marceloxreis/sistema-embarcados/(commit log)

2026-10-22 Entrega inicial: controle de acesso ESP32 com biometria, auditoria e buzzer
    [BuzzerLogic.h, Config.example.h, DoorLogic.h, test_buzzer.cpp, test_buzzer.py, test_door.cpp, test_server.py]
2026-10-30 Arquitetura Mega 2560 + ESP32-CAM com foto por acesso autorizado
    - Firmware MegaControlador: controle local, EEPROM com journal, contador de
    boot, fila de eventos, UART com a CAM atendida durante esperas, recuperacao
    de DY50/LCD, diagnostico BOOT/STATUS.
    - Firmware Esp32CamRede: captura com prova de frescor, fila com JPEG, envio
    HTTP com descarte de rejeicao permanente e espera entre reenvios, NTP,
    encaminhamento de reset web.
    - Protocolo UART compartilhado (enquadramento, CRC, mensagens).
    - Servidor: fotos, contadores de perda, expiracao de reset pendente,
    respostas 400/404 robustas; painel com tratamento de sessao e erros.
    - Testes de host com dubles (126), guia de montagem fio a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
    [BootCounter.h, BuzzerLogic.h, Config.example.h, DoorLogic.h, Dy50ResponseFilter.h, Esp32CamRede.ino, MegaControlador.ino, MessageProtocol.h]
2026-10-30 Corrige pendencias P2 do Mega, painel e registros da sessao 2
    - MEGA-07: textos do LCD com ate 16 colunas; codigo de auditoria separado do texto
    - REQ-E4: mensagem explicita de falha de memoria (indisponivel ou registro corrompido)
    - MEGA-03: digital orfa no DY50 e apagada no cadastro, com nova busca
    - MEGA-04: ate 3 falhas passageiras de getImage toleradas no cadastro
    - MEGA-10: boot sonda o LCD antes de inicializar
    - TST-02: testes de debounce, LED RGB, LCD com ID, teclas, pin_in_use e porta
    - Painel: foco preservado, status do reset junto ao formulario, PIN incorreto
    - Docs: HANDOFF, VALIDACAO, TESTES e MONTAGEM atualizados
    Nada testado em hardware. LOCK_MODE=0.
    [MegaControlador.ino, test_lcd_textos.py, test_mega_logic.py, test_mega_tst02.py, test_reinicio_perifericos_agent.py]
2026-10-30 Adiciona simulacao Wokwi do Mega e descarta CAM-03 e SRV-02
    - simulacao/wokwi: diagrama do Mega com LCD I2C, teclado, LED RGB,
    buzzer, saida da fechadura e sensores de porta; build.sh compila com
    Config.example.h; cenarios de boot com porta fechada e aberta
    - Cenarios rodados no Wokwi (simulado): boot, AUTH, STATUS, queued=1
    e queued=2 com forced_open; LCD mostra "Senha ou digital"
    - Docs: resultados no VALIDACAO e HANDOFF; CAM-03 e SRV-02 descartados
    pelo dono; bancada adiada
    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
2026-10-30 Adiciona cenarios Wokwi do teclado, LED RGB e fechadura
    - diagram-teclado-botoes.json: 16 botoes em matriz (D22-D29) no lugar
    do teclado de membrana, que nao tem controle de automacao no Wokwi
    - Cenarios rodados (simulado): senha errada acende o vermelho e mostra
    "Acesso negado"; PIN admin abre o menu (magenta); D cancela
    - Docs: resultados no VALIDACAO, HANDOFF e LEIAME; buzzer ainda nao exercitado
    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
2026-10-30 Prepara handoff para retomada com /sistema-embarcado
